Ravanger/esp32-desk-gadget/assets/oled-display.jpg

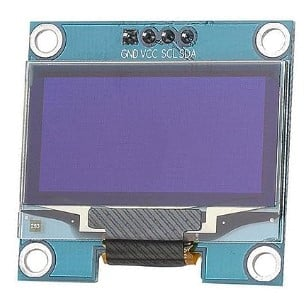
assets/oled-display.jpg
