Ravanger/esp32-desk-gadget/(commit log)

2026-10-23 Add README.md — ESP32 desk gadget build guide
2026-10-23 Add docs/parts.md — ESP32 desk gadget build guide
2026-10-23 Add docs/wiring.md — ESP32 desk gadget build guide
2026-10-23 Add docs/libraries-and-setup.md — ESP32 desk gadget build guide
2026-10-23 Add docs/how-it-works.md — ESP32 desk gadget build guide
2026-10-23 Add docs/build-order.md — ESP32 desk gadget build guide
2026-10-23 Add docs/troubleshooting.md — ESP32 desk gadget build guide
2026-10-23 Add docs/sources.md — ESP32 desk gadget build guide
2026-10-23 Add firmware/desk_gadget.ino — ESP32 desk gadget build guide
2026-10-23 Add assets/oled-display.jpg — ESP32 desk gadget build guide
2026-10-23 Add assets/esp32-oled-wiring.png — ESP32 desk gadget build guide
2026-10-23 Add assets/encoder-wiring.png — ESP32 desk gadget build guide
2026-10-23 Add assets/encoder-internal.png — ESP32 desk gadget build guide
2026-10-23 Add credited pictures from other guides to docs/wiring.md
2026-10-23 Switch guide and sketch to ESP32-C3 SuperMini pins (README.md)
2026-10-23 Switch guide and sketch to ESP32-C3 SuperMini pins (docs/parts.md)
2026-10-23 Switch guide and sketch to ESP32-C3 SuperMini pins (docs/wiring.md)
2026-10-23 Switch guide and sketch to ESP32-C3 SuperMini pins (docs/libraries-and-setup.md)
2026-10-23 Switch guide and sketch to ESP32-C3 SuperMini pins (docs/how-it-works.md)
2026-10-23 Switch guide and sketch to ESP32-C3 SuperMini pins (docs/build-order.md)
2026-10-23 Switch guide and sketch to ESP32-C3 SuperMini pins (docs/troubleshooting.md)
2026-10-23 Switch guide and sketch to ESP32-C3 SuperMini pins (docs/sources.md)
2026-10-23 Switch guide and sketch to ESP32-C3 SuperMini pins (firmware/desk_gadget.ino)
2026-10-23 Rewrite for general public: configurable location/timezone, verified specs (docs/wiring.md)
2026-10-24 Audit C3 SuperMini build: sketch safety/perf fixes, doc accuracy, local guardrails
    - Sketch: non-blocking time check, bounded TLS/HTTP timeouts, I2C probe,
    NaN-safe display, weather fetch on WiFi only, optional low TX power.
    - Docs: electrical/power safety, verified specs and sources, consistent
    PIR and fetch wording, pinned PlatformIO example.
    - Guardrails: scripts/check.py (pins, WMO, secrets, links, LF, compile),
    versioned pre-commit/pre-push hooks, PR template, .gitattributes.
2026-10-24 Add USE_BUTTON_NAV: push button on GPIO 10 as encoder alternative; bounce-safe press
2026-10-24 Address PR #6 review: button wording in build order/tests, compile all-options variant
2026-10-24 Make the push button the default nav input; rotary encoder optional (USE_ENCODER)
2026-10-24 Self-host guide images with credits; record core 3.3.12 compile
    - Add section-matched images (SuperMini pinout, DHT11, button, PIR,
    pot, switch bounce, voltage divider) and move all existing images
    into assets/ instead of hotlinking; credits in docs/sources.md.
    - check.py: fail on hotlinked markdown images.
    - Sketch header: button-first wording.
    - Both sketch configurations compile on arduino-esp32 3.3.12
    (pioarduino 55.03.312-1); docs updated.
2026-10-24 Address PR #7 review: qualify core 3.x claim, give exact install line, licence caveat
    - README/sketch header: 2.0.17 is the recommended, check.py-verified core;
    3.3.12 is a single-machine manual build; Nologo board entry untested.
    - libraries-and-setup/verified-specs: exact pioarduino release-zip platform
    line, flash headroom recommendation.
    - sources.md: credits are not a licence; re-clear before public/commercial
    use; source URL on every image row.
2026-10-24 Add ESPHome firmware as Home Assistant alternative
    Implements #8 (hardware flash test and Home Assistant registration
    still pending bench steps). Same hardware, wiring, and screens as
    the Arduino sketch; outdoor weather imported from Home Assistant.
    Validated with esphome config and compile on ESPHome 2026.10.0.
2026-10-24 Address PR #9 review: ESPHome parity fixes and stronger checks
    - DHT and Home Assistant imports: filter_out NaN. ESPHome publishes
    NaN on a failed read, so "last good value" was not actually kept.
    - WiFi reboot_timeout 0s: the 15 min default rebooted the gadget
    while WiFi was down, contradicting the documented behaviour.
    - min_version 2024.6.0: list-form ota: fails on 2024.4.0.
    - PIR: restarting 60 s script driven by motion, button, and encoder,
    armed at boot, as in the sketch. A button wake no longer leaves the
    display on forever; the Motion entity now follows the PIR directly.
    - Text drawn on GFX baselines: Roboto Mono's taller ascender pushed
    the bottom lines into the page dots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
2026-10-24 Average indoor DHT11 readings over the last 5 good reads
    The DHT11 reports whole degrees and whole percent, so the display
    flipped between neighbouring values. Both firmwares now show the mean
    of the last 5 good reads (~12.5 s): a ring buffer in the sketch, a
    sliding_window_moving_average filter after filter_out: nan in ESPHome.
2026-10-24 Make ESPHome the default firmware; require ESPHome 2026.10.0 with OTA encryption
    - README, AGENTS.md, YAML and sketch headers: ESPHome is the default,
    the Arduino sketch the standalone backup for builders without Home
    Assistant. Both must stay in parity.
    - Doc order: ESPHome moves to step 3, ahead of the sketch setup page;
    build-order and hardware-tests note how to run their sketch-written
    steps with the ESPHome build.
    - min_version 2026.10.0 (the compiled release). OTA uses encryption
    inherited from the API key instead of a password, which removes the
    flash/RAM warning and the ota_password secret.
2026-10-24 docs: esphome troubleshooting points to setup step 6 (add device)
